ZY-zhangye/riscv-cpu-refactored/doc/HANDOFF_20261018.md

# 2026-10-18 HelloZynq 五级 RV32 SoC 工作区交接

交接时区：Asia/Singapore（UTC+08:00）。工作区 `W:\riscv-cpu-refactored`，分支 `dev/linux-bringup`。本轮目标是把**现有单发顺序五级 RV32 SoC**适配到 HelloZynq-7020，以片内 ROM/BRAM、UART 和裸机 CoreMark 验证并扫描频率。本轮没有实现 Linux、Sv32、cache、A 扩展或新增 CPU 功能；分支名字和既有 Linux 路线不改变这个范围。

## 接手首先掌握

- 50 MHz smoke 已在真实板卡输出 `SMOKE_PASS`，50 MHz CoreMark 有效通过。
- 本轮 10 MHz 步进里，**100 MHz 是同时满足所设 STA 约束并通过 CoreMark 的最高点**；WNS `+0.259 ns`、WHS `+0.048 ns`，CoreMark `214.830878`。
- **160 MHz 是实板 CoreMark 最高通过点**，两次运行复现，`343.752372` CoreMark、`2.148452` CoreMark/MHz，CRC 正确，计时 `17.454425 s`、6,000 次迭代。它的 WNS 为 **−2.449 ns**，属于超频实验，不是时序保证频率。
- 170 MHz 两次下载后分别采集约 180 秒，均 0 字节、没有 BOOT/结果；没有得到 CRC 错误。未测 165 MHz，不能宣称精确频率极限。
- 最后恢复并验证的是 **160 MHz 易失 JTAG 配置**，最后成功下载记录为当日 `21:25:35 +08:00`。没有写 QSPI/SD；断电后须重新加载。计算机关机若使板卡失电也会丢失配置。
- `rtl/cpu_top/` 本轮未改；不要将板级接线、SoC 返回时序修复和除法器替换描述为新增流水线架构。

详细性能、STA、资源和限制以 [HELLOZYNQ_COREMARK_RESULTS.md](HELLOZYNQ_COREMARK_RESULTS.md) 为准；准备阶段资料见 [HELLOZYNQ_BOARD_READINESS.md](HELLOZYNQ_BOARD_READINESS.md)，其中“尚未实板运行”等文字是该阶段历史状态。

## 本轮文件与行为变化

| 文件/目录 | 内容 |
| --- | --- |
| `rtl/my_cpu/my_cpu.sv` | 增加 `BOARD_MEMORY`、`INST_INIT_FILE`、`DATA_INIT_FILE`；真实同步 ROM/BRAM 初始化与仿真旧路径共存 |
| `rtl/my_cpu/bridge.sv` | 修正 UART/Timer/PLIC 同边沿更新 rdata 后被再次采到旧值的问题；按同步 BRAM/旧组合读 RAM 分别适配返回 |
| `rtl/board/hellozynq_top.sv` | HelloZynq 引脚壳、MMCM、BUFG、等待 LOCKED 后同步释放复位及上电延迟；直接实例现有 SoC |
| `rtl/board/rv32_divider_hw.sv` | 可综合的真实 32 步迭代除法器，模块名 `divider`；板级清单用它替换 `rtl/cpu_top/divider.sv`，不能同时编入 |
| `board/hellozynq/hellozynq.xdc` | 6 个板级 IO、50 MHz 输入时钟及外部异步边界约束 |
| `board_tests/platform/board_start.S`、`board_linker.ld`、`board_runtime.c/.h` | 裸机启动、BSS/栈、极小整数打印、Timer 和 UART 移植 |
| `board_tests/00_smoke/main.c` | 最小功能启动/外设验证程序 |
| `board_tests/05_coremark/src/core_portme.c/.h` | 当前平台移植和精确计分；CoreMark 五份算法/框架源保持原内容 |
| `scripts/` | 固件构建和 ELF/镜像检查、独立 Vivado 工程、串口采集、ISA 回归、频率扫描 |
| `test/tb_soc_bus_response.sv`、`tb_board_divider.sv`、`tb_board_firmware.sv` | SoC 总线集成、真实除法器和整核裸机固件验证 |
| `doc/board_evidence/2026-10-18/` | 可进入版本管理的报告、参数、哈希与最终 UART 原始字节 |

原始 CPU 五级流水、UART/Timer/PLIC 主体及日常 `run_all.bat` 保持原范围。当前 FPU 仍是占位实现，`INSTRET` 仍有估算补偿，本轮结果不能换算 IPC、CPI 或 MIPS。

## 工具与硬件

| 工具/资料 | 当前绝对路径 |
| --- | --- |
| Vivado 2023.2 | `W:\APP\Xilinx\Vivado\2023.2\bin\vivado.bat` |
| Questa 2024.1 | `W:\questasim64_2024.1\win64\`，含 `vlib.exe/vmap.exe/vlog.exe/vsim.exe` |
| Windows 原生 RISC-V GCC 15.2.0-1 | `F:\Tools\Apps\xpack-riscv-none-elf-gcc-15.2.0-1\bin\` |
| Python 3.14 | 本机 Python 3.14，`python` 在 PATH 中 |
| 串口 Python（已装 pyserial） | 已装 pyserial 的独立 venv，下文记为 `<serial-python>` |
| PowerShell 7 | `pwsh` 在 PATH 中 |
| Icarus | `C:\ProgramData\chocolatey\bin\iverilog.exe`，同目录 `vvp.exe` |
| 原厂资料 | `F:\BaiduNetdiskDownload\zynq` |

Vivado 工程采用教程候选 part `xc7z020clg484-2`，实物 JTAG 只确认 `xc7z020`，封装 CLG484 来自用户提供的文字。**实物速度档、温度等级、PCB 版本未核实**，不要用工程 part 反推实物 -2/I。V1.0 按键及排针丝印有厂商勘误，以球位而不是 KEY1/2 名称为准。

| 顶层信号 | CLG484 球位 | 约定 |
| --- | --- | --- |
| `clk` | M19 | 板载 50 MHz，20 ns，LVCMOS33 |
| `rst_n` | J20 | 上拉、按下接地；低有效 PL 用户按键 |
| `uart_rx` | M17 | CH340E TX → FPGA，LVCMOS33 |
| `uart_tx` | L17 | FPGA → CH340E RX，LVCMOS33 |
| `led[0:1]` | P20/P21 | 高有效，LVCMOS33 |

UART 在 PL Bank34，原理图 `PS_UART_*` 只是网名；无需 PS MIO/EMIO。主机此前为 COM6，CH340 VID/PID `1A86:7523`，115200/8N1/无流控，重插后重新枚举。唯一 JTAG 目标曾为 `localhost:3121/xilinx_tcf/Digilent/<序列号>`；每次 Program 都重新检查。正确 DONE 属性为 `REGISTER.CONFIG_STATUS.BIT13_DONE_INTERNAL_SIGNAL_STATUS` 和 `REGISTER.CONFIG_STATUS.BIT14_DONE_PIN`，旧缩写 `BIT13_DONE` 不存在。

SoC 普通 reset PC=`0x80000000`，指令 ROM 16 KiB；数据 RAM=`0x80100000..0x8013FFFF`，256 KiB，栈顶=`0x80140000`。UART/Timer/LED 基址依次为 `0x80010000/0x80020000/0x80030000`，PLIC 在 `0x8030xxxx`。编译为 `rv32im_zicsr/ilp32`，不能用 xPack 默认 `rv32imac` 引入未实现 A/C。UART 使用内部 CPU 时钟分频，CTRL=`0x14`；50 MHz BAUD=`433`，160 MHz BAUD=`1388`。

## 构建、恢复、下载和采集

以下从 `W:\riscv-cpu-refactored` 的 PowerShell 7 运行。每次选择全新输出目录；示例中的 `new_*` 是待生成目录，不代表已有证据。`Gen` 只生成固件和配置，`Build` 生成独立 Vivado 工程/报告/bit。本机旧 npm PATH 联接曾使 Vivado 崩溃，入口已仅对子进程采用最小 PATH；不需修改全局 PATH。

```powershell
# 新建50 MHz smoke：编译、检查镜像、综合、实现与写bit
pwsh -File scripts/run_board.ps1 -Mode Build -App smoke -CpuHz 50000000 -Iterations 0 -BuildDir W:\riscv-cpu-refactored\build\hello_zynq\new_smoke50

# 新建100 MHz正式CoreMark，iterations=0由固件校准到至少10秒
pwsh -File scripts/run_board.ps1 -Mode Build -App coremark -CpuHz 100000000 -Iterations 0 -BuildDir W:\riscv-cpu-refactored\build\hello_zynq\new_core100

# 仅构建固件：inst.mem/data.mem、ELF、dump、COE和manifest
python scripts/build_board_firmware.py --app coremark --cpu-hz 100000000 --iterations 0 --output W:\riscv-cpu-refactored\build\hello_zynq\new_firmware100

# 已完成route但只在报告/写bit阶段失败时复用，不重跑综合/实现
pwsh -File scripts/run_board.ps1 -Mode Finish -BuildDir <已有构建目录>

# 在一个终端先开被动采集；output必须是新目录，等待CAPTURE_READY
& <serial-python> scripts/board_capture.py --port COM6 --baud 115200 --duration 180 --cpu-hz 100000000 --require-valid-coremark --output W:\riscv-cpu-refactored\build\hello_zynq\new_capture100

# 另一个终端再加载已检查的bit（会改变板上易失配置）
pwsh -File scripts/run_board.ps1 -Mode Program -BuildDir <已有100MHz构建目录>
```

`Program` 依据 `build_summary.json` 校验 bit SHA-256、DRC 和唯一目标，然后检查 DONE、要求 `BOARD_PROGRAM_SUCCESS`。160 MHz 等 STA 未收敛点必须显式加 `-AllowTimingFailure`，不能把它写成基线 PASS。`Finish` 只容许两份报告脚本变化；RTL/XDC/镜像变化需新建完整构建，不要删除快照或绕过检查。采集器只收字节不发串口命令；遇 CoreMark 结果会独立复算，不够 10 秒为 SHORT。不要将 smoke程序不存在的 PING/ECHO 协议套过来。

频率扫描入口 `scripts/run_frequency_campaign.py` 默认每点独立构建、先采集后下载，`--confirm-failure` 对首次失败再试一次。仅查看计划、不触硬件可用：

```powershell
python scripts/run_frequency_campaign.py --start-mhz 60 --step-mhz 10 --max-mhz 170 --iterations 0 --root-output W:\riscv-cpu-refactored\build\hello_zynq\new_campaign --plan-only
```

当前已测固件 builder 限制最高 **200 MHz**，而 campaign 参数默认最高为 400 MHz。重新运行时应显式设置 `--max-mhz` 不超过 200；超出会被 builder 拦截，属于 `TOOL_BLOCKED`，不是实板频率失败。为保持已测源码哈希，收尾未改这两处限制。

## 回归与已完成验证

本轮隔离 Questa 回归为 **77/77 指令用例、8/8 定向测试 PASS**，共享 `hex/riscv-tests/rv32-p-riscv.hex` 前后 SHA 一致。真实除法器裸接口 1,098 组、mul 集成 540 组及 kill/drain/reset 通过；SoC sync/async 返回共17项检查通过；50 MHz smoke及短 CoreMark整核仿真通过。原始回归与板级构建的 divider选择不同，不能只通过旧行为模型就替代硬件除法器验收。

```powershell
python scripts/run_board_regression.py --build-dir W:\riscv-cpu-refactored\build\hello_zynq\new_regression --tool-dir W:\questasim64_2024.1\win64
pwsh -File run_board_divider.ps1 -BuildDir W:\riscv-cpu-refactored\build\hello_zynq\new_divider
pwsh -File scripts/run_board_firmware_sim.ps1 -FirmwareDir <已构建smoke固件目录> -PassText SMOKE_PASS -BuildDir W:\riscv-cpu-refactored\build\hello_zynq\new_firmware_sim
```

旧 `run_all.bat all` 也保留，但会临时覆盖共享 HEX且末尾pause；优先用上述隔离入口。新建回归目录避免混用旧 work 库。

收尾时为补齐持久日志，已重跑硬件除法定向测试，结果 `BOARD_DIVIDER_PASS raw=1098 mul=540 kill_drain=3 reset=2`，见 `build/hello_zynq/handoff_checks/board_divider.log`。

## STA、CDC及结果边界

50 MHz CoreMark WNS=`+5.950 ns`、WHS=`+0.060 ns`，成绩 `107.415435`。160 MHz WNS=`−2.449 ns`、TNS=`−6463.526 ns`、WHS=`+0.062 ns`、THS=0；失败端点包括5,511个CPU setup和671个reset recovery，最差 EX 结果路径 `ds_to_es_bus_r_reg[5]` → `skid_exe_result_reg[25]`，以及板级复位扇出。170 MHz WNS=`−2.984 ns`、WHS=`+0.050 ns`；不能说hold失败。

160 MHz全SoC资源：LUT 6,723、FF 5,368、BRAM36 68/140、DSP 4/220。DRC严重项为0仍有33条Warning；CDC为 **CDC-7 Critical 12条、CDC-2 Warning 1条、CDC-9 Info 1条**，涉及复位异步端和UART同步链属性。没有通过全CDC签收；不要用“DRC严重项0”写成所有检查全绿。默认活动功耗估计不是实测功耗。

## 保留的证据与交付物

| 内容 | 路径（相对仓库） |
| --- | --- |
| 参数、性能与限制主报告 | `doc/HELLOZYNQ_COREMARK_RESULTS.md` |
| 可持久保留的160MHz原始报告/参数/串口 | `doc/board_evidence/2026-10-18/160mhz/` |
| 全频率结果 | `doc/board_evidence/2026-10-18/frequency_results.csv`、`frequency_results.json` |
| 本轮完整扫描记录 | `build/hello_zynq/campaign_10mhz_20261018/campaign.json` |
| 已通过50MHz构建 | `build/hello_zynq/coremark_50_base/`，smoke为 `build/hello_zynq/smoke_50_v2/` |
| 最后160MHz bit/固件/配置/下载记录 | `build/hello_zynq/campaign_10mhz_20261018/coremark_160MHz/` |
| 100MHz时序满足镜像 | `build/hello_zynq/campaign_10mhz_20261018/coremark_100MHz/hellozynq.bit` |
| 最后160MHz原始串口 | `build/hello_zynq/campaign_10mhz_20261018/final_160MHz_capture/` |
| 隔离回归汇总 | `build/hello_zynq/isa_regression/regression_results.json` |
| 参数说明附件包 | `build/hello_zynq/reports/HelloZynq-160MHz-parameters-20261018.zip` |

`build/` 属于忽略的本地产物。主工作区保留所有实板构建项目以及100/160MHz镜像，只在归档后清理可再生Questa库/空 `.Xil` 等缓存；文档证据目录已经复制并逐文件核对160MHz关键材料。收尾归档目录指定为 `F:\Tools\Archives\riscv-cpu-refactored\2026-10-18\`，归档完成与否及每个文件的实际SHA以该目录最终的 `handoff-manifest.json` 为准。规划包含 `source-and-history.bundle`、`source-snapshot.zip`、`board-builds-and-evidence.zip`；这些名字是收尾输出约定，不冒充文档编写时已经验证的文件。源代码将做本地git提交、不推送；接手执行 `git log -1 --oneline` 查看实际最新提交。不要把只有文本报告的参数包误认为完整可重载镜像包。

最终160MHz bit SHA-256=`e54c1900dfd46192d3420c7d33409db9ff96f67ad293f3adb3fe076308596109`；ELF=`d7d04054163038a7f805ef723ee49050ddd4f9ba50cc743f4276f230fd379d5c`；最终UART原始字节=`847be1f58ae811f11d26c883e12da18470a6a15f193e3e96661674f4388aae8a`。先核对哈希再重载，不从缓存项目重新生成后仍声称是同一实测镜像。

两点历史复现边界：`smoke_50_v2` 使用 CRLF 修复前的 runtime，应保留原 ELF/mem 与 manifest，不可用当前源码重建后仍标为原镜像。`board_capture.py` 保存的 `uart.txt` 可有 Windows 文本换行导致的 CRCRLF 空行，以 `rx.bin/rx.jsonl` 作为原始字节证据；文档证据目录另有 `uart_normalized.txt`。工程/manifest 包含本机绝对 W/F/C 路径，换机应使用新输出目录及工具参数重建，不假定压缩包移位后 XPR 可直接原样打开。

## 后续权限

接手后先查看本地git提交、交接包清单与文档证据，确认硬件是否仍供电、COM/JTAG是否变化。后续是否修复高频路径、优化reset/CDC、细测165MHz或进入Linux路线，均由用户决定；不要因为尚有性能/规范缺口就自行扩展CPU功能或继续频率扫描。
