ZY-zhangye/riscv-cpu-refactored/doc/board_evidence/2026-10-18/frequency_results.csv

MHz | attempt | runtime_status | iterations | cycles | duration_seconds | score | per_MHz | WNS_ns | WHS_ns | timing_met | UART_bytes
50 | 1 | PASS | 2000 | 930964900 | 18.619298 | 107.4154353187751761639993087 | 2.148308706375503523279986174 | 5.95 | 0.06 | True | 1275
60 | 1 | PASS | 2000 | 930964860 | 15.516081 | 128.8985279208068068219030308 | 2.14830879868011344703171718 | 3.07 | 0.088 | True | 1468
70 | 1 | PASS | 2000 | 930964860 | 13.299498 | 150.3816159076079412922202026 | 2.14830879868011344703171718 | 0.943 | 0.06 | True | 1468
80 | 1 | PASS | 3000 | 1396582880 | 17.457286 | 171.8480180710793189731783050 | 2.148100225888491487164728812 | 0.93 | 0.059 | True | 1471
90 | 1 | PASS | 3000 | 1396447200 | 15.51608 | 193.3478043423338884563626895 | 2.14830893713704320507069655 | 0.242 | 0.06 | True | 1471
100 | 1 | PASS | 3000 | 1396447300 | 13.964473 | 214.8308783296011242243083574 | 2.148308783296011242243083574 | 0.259 | 0.048 | True | 1476
110 | 1 | PASS | 3000 | 1396447250 | 12.694975 | 236.3139746238176916457102121 | 2.148308860216524469506456474 | -0.267 | 0.071 | False | 1476
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
