ZY-zhangye/riscv-cpu-refactored/rtl/cpu_top/cpu_top.sv

`include "defines.svh"
module cpu_top (
    input logic clk,
    input logic rst_n,
    //指令存储器接口
    input logic [31:0] imem_rdata,
    output logic [31:0] imem_addr,
    output logic imem_en,
    //数据存储器接口
    input logic [31:0] dmem_rdata,
    output logic [31:0] dmem_addr,
    output logic [3:0] dmem_wen,
    output logic dmem_en,
    output logic [31:0] dmem_wdata,
    //plic接口
    input logic plic_irq
    //debug接口
    `ifdef DEBUG_EN
    ,
    output logic [31:0] debug_wb_pc,
    output logic [4:0] debug_wb_rf_addr,
    output logic [31:0] debug_wb_rf_data,
    output logic debug_wb_rf_wen,
    output logic debug_wb_fpu_rf_wen,
    output logic [31:0] debug_data
    `endif
);

    //连接if模块
    logic ds_allowin;
    logic fs_to_ds_valid;
    logic [`FS_DS_WIDTH-1:0] fs_to_ds_bus;
    logic br_taken;
    logic [31:0] br_target;
    logic br_redirect;
    logic [31:0] br_redirect_target;
    logic bp_update_valid;
    logic [31:0] bp_update_pc;
    logic bp_update_taken;
    logic [31:0] bp_update_target;
    logic bp_update_is_jalr;
    logic [`EXC_WIDTH-1:0] fs_exc_bus;
    logic exception_flag;
    logic [31:0] exception_addr;
    logic external_irq_enable;

    //连接id模块
    logic [4:0] rs1_addr;
    logic [4:0] rs2_addr;
    logic [31:0] rs1_data;
    logic [31:0] rs2_data;
    logic [4:0] rs1_fpu_addr;
    logic [4:0] rs2_fpu_addr;
    logic [4:0] rs3_fpu_addr;
    logic rs3_fpu_ren;
    logic [31:0] rs1_fpu_data;
    logic [31:0] rs2_fpu_data;
    logic [11:0] csr_addr;
    logic [31:0] csr_data;
    logic ds_to_es_valid;
    logic es_allowin;
    logic ds_flush;
    logic [`DS_ES_WIDTH-1:0] ds_to_es_bus;
    logic regfile_wen;
    logic reg_fpu_wen;
    logic [4:0] regfile_waddr;
    logic [`DATA_WIDTH-1:0] regfile_wdata;
    logic [4:0] exe_dest_addr;
    logic exe_regfile_wen;
    logic exe_reg_fpu_wen;
    logic [11:0] exe_csr_addr;
    logic exe_csr_wen;
    logic exe_load_pending;
    logic exe_lw_live_ok;
    logic exe_stack_lw_hit;
    logic exe_store_pending;
    logic exe_result_pending;
    logic stack_query_valid;
    logic [31:0] stack_query_addr;
    logic stack_query_hit;
    logic [31:0] stack_query_data;
    logic stack_capture_valid;
    logic [31:0] stack_forward_data;
    logic stack_store_valid;
    logic stack_store_allocate;
    logic [4:0] mem_dest_addr;
    logic mem_regfile_wen;
    logic mem_reg_fpu_wen;
    logic [`EXC_WIDTH-1:0] ds_exc_bus;

    //连接es模块
    logic es_valid;
    logic ms_allowin;
    logic es_to_ms_valid;
    logic [`ES_MS_WIDTH-1:0] es_to_ms_bus;
    logic es_flush;
    logic [31:0] mem_result;
    logic mem_lw_live_valid;
    logic [31:0] mem_lw_live_data;
    logic [31:0] reg_fpu_data3;
    logic [`EXE_EXC_BUS - 1:0] exe_exc_bus;

    //连接ms模块
    logic ms_valid;
    logic [`MS_WS_WIDTH-1:0] ms_to_ws_bus;
    logic ms_to_ws_valid;
    logic ws_allowin;
    logic csr_we;
    logic [11:0] csr_waddr;
    logic [31:0] csr_wdata;
    logic [6:0] exception_code;
    logic [31:0] exception_mtval;
    logic valid_inst;
    assign valid_inst = br_taken;

    //实例化
    if_stage u_if_stage (
        .clk(clk),
        .rst_n(rst_n),
        .pc_out(imem_addr),
        .inst_ren(imem_en),
        .inst_in(imem_rdata),
        .ds_allowin(ds_allowin),
        .fs_to_ds_valid(fs_to_ds_valid),
        .fs_to_ds_bus(fs_to_ds_bus),
        .br_taken(br_redirect),
        .br_target(br_redirect_target),
        .bp_update_valid(bp_update_valid),
        .bp_update_pc(bp_update_pc),
        .bp_update_taken(bp_update_taken),
        .bp_update_target(bp_update_target),
        .bp_update_is_jalr(bp_update_is_jalr),
        .fs_exc_bus(fs_exc_bus),
        .exception_flag(exception_flag),
        .exception_addr(exception_addr)
    );

    id_stage u_id_stage (
        .clk(clk),
        .rst_n(rst_n),
        .fs_to_ds_valid(fs_to_ds_valid),
        .fs_to_ds_bus(fs_to_ds_bus),
        .ds_allowin(ds_allowin),
        .rs1_addr(rs1_addr),
        .rs2_addr(rs2_addr),
        .rs1_data(rs1_data),
        .rs2_data(rs2_data),
        .rs1_fpu_addr(rs1_fpu_addr),
        .rs2_fpu_addr(rs2_fpu_addr),
        .rs3_fpu_addr(rs3_fpu_addr),
        .rs3_fpu_ren(rs3_fpu_ren),
        .rs1_fpu_data(rs1_fpu_data),
        .rs2_fpu_data(rs2_fpu_data),
        .csr_addr(csr_addr),
        .csr_data(csr_data),
        .ds_to_es_valid(ds_to_es_valid),
        .es_allowin(es_allowin),
        .ds_flush(ds_flush),
        .ds_to_es_bus(ds_to_es_bus),
        .regfile_wen(regfile_wen),
        .reg_fpu_wen(reg_fpu_wen),
        .regfile_waddr(regfile_waddr),
        .regfile_wdata(regfile_wdata),
        .exe_dest_addr(exe_dest_addr),
        .exe_regfile_wen(exe_regfile_wen),
        .exe_reg_fpu_wen(exe_reg_fpu_wen),
        .exe_csr_addr(exe_csr_addr),
        .exe_csr_wen(exe_csr_wen),
        .exe_load_pending(exe_load_pending),
        .exe_lw_live_ok(exe_lw_live_ok),
        .exe_stack_lw_hit(exe_stack_lw_hit),
        .exe_store_pending(exe_store_pending),
        .exe_result_pending(exe_result_pending),
        .es_valid(es_valid),
        .stack_query_valid(stack_query_valid),
        .stack_query_addr(stack_query_addr),
        .stack_query_hit(stack_query_hit),
        .mem_dest_addr(mem_dest_addr),
        .mem_regfile_wen(mem_regfile_wen),
        .mem_reg_fpu_wen(mem_reg_fpu_wen),
        .ms_valid(ms_valid),
        .br_taken(br_redirect),
        .exception_flag(exception_flag),
        .fs_exc_bus(fs_exc_bus),
        .ds_exc_bus(ds_exc_bus)
    );

    exe_stage u_exe_stage (
        .clk(clk),
        .rst_n(rst_n),
        .ds_to_es_valid(ds_to_es_valid),
        .ms_allowin(ms_allowin),
        .ds_to_es_bus(ds_to_es_bus),
        .ds_flush(ds_flush),
        .es_allowin(es_allowin),
        .es_to_ms_valid(es_to_ms_valid),
        .es_flush(es_flush),
        .es_to_ms_bus(es_to_ms_bus),
        .dmem_addr(dmem_addr),
        .dmem_wen(dmem_wen),
        .dmem_en(dmem_en),
        .dmem_wdata(dmem_wdata),
        .exe_dest_addr(exe_dest_addr),
        .exe_regfile_wen(exe_regfile_wen),
        .exe_reg_fpu_wen(exe_reg_fpu_wen),
        .exe_csr_addr(exe_csr_addr),
        .exe_csr_wen(exe_csr_wen),
        .exe_load_pending(exe_load_pending),
        .exe_lw_live_ok(exe_lw_live_ok),
        .exe_stack_lw_hit(exe_stack_lw_hit),
        .exe_store_pending(exe_store_pending),
        .exe_result_pending(exe_result_pending),
        .es_valid(es_valid),
        .ds_exc_bus(ds_exc_bus),
        .exception_flag(exception_flag),
        .br_taken(br_taken),
        .br_target(br_target),
        .br_redirect(br_redirect),
        .br_redirect_target(br_redirect_target),
        .bp_update_valid(bp_update_valid),
        .bp_update_pc(bp_update_pc),
        .bp_update_taken(bp_update_taken),
        .bp_update_target(bp_update_target),
        .bp_update_is_jalr(bp_update_is_jalr),
        .mem_result(mem_result),
        .mem_lw_live_valid(mem_lw_live_valid),
        .mem_lw_live_data(mem_lw_live_data),
        .stack_forward_data(stack_forward_data),
        .reg_fpu_data3(reg_fpu_data3),
        .stack_store_valid(stack_store_valid),
        .stack_store_allocate(stack_store_allocate),
        .exe_exc_bus(exe_exc_bus)
    );

    stack_value_buffer u_stack_value_buffer (
        .clk(clk),
        .rst_n(rst_n),
        .query_valid(stack_query_valid),
        .query_addr(stack_query_addr),
        .query_hit(stack_query_hit),
        .query_data(stack_query_data),
        .capture_en(exe_stack_lw_hit),
        .capture_addr(dmem_addr),
        .capture_flush(exception_flag || br_redirect),
        .captured_valid(stack_capture_valid),
        .captured_data(stack_forward_data),
        .store_valid(stack_store_valid),
        .store_allocate(stack_store_allocate),
        .store_addr(dmem_addr),
        .store_wstrb(dmem_wen),
        .store_wdata(dmem_wdata)
    );

    mem_stage u_mem_stage (
        .clk(clk),
        .rst_n(rst_n),
        .es_flush(es_flush),
        .es_to_ms_bus(es_to_ms_bus),
        .ms_to_ws_bus(ms_to_ws_bus),
        .es_to_ms_valid(es_to_ms_valid),
        .ms_to_ws_valid(ms_to_ws_valid),
        .ms_allowin(ms_allowin),
        .ws_allowin(ws_allowin),
        .dmem_rdata(dmem_rdata),
        .mem_dst_addr(mem_dest_addr),
        .mem_regfile_wen(mem_regfile_wen),
        .mem_reg_fpu_wen(mem_reg_fpu_wen),
        .mem_result(mem_result),
        .mem_lw_live_valid(mem_lw_live_valid),
        .mem_lw_live_data(mem_lw_live_data),
        .ms_valid(ms_valid),
        .exception_flag(exception_flag),
        .exe_exc_bus(exe_exc_bus),
        .plic_irq(plic_irq),
        .external_irq_enable(external_irq_enable),
        .csr_we(csr_we),
        .csr_waddr(csr_waddr),
        .csr_wdata(csr_wdata),
        .exception_code(exception_code),
        .exception_mtval(exception_mtval)
    );

    wb_stage u_wb_stage (
        .clk(clk),
        .rst_n(rst_n),
        .ms_to_ws_bus(ms_to_ws_bus),
        .ms_to_ws_valid(ms_to_ws_valid),
        .ws_allowin(ws_allowin),
        .regfile_wen(regfile_wen),
        .reg_fpu_wen(reg_fpu_wen),
        .regfile_addr(regfile_waddr),
        .regfile_wdata(regfile_wdata)
        `ifdef DEBUG_EN
        ,
        .debug_wb_pc(debug_wb_pc),
        .debug_wb_rf_addr(debug_wb_rf_addr),
        .debug_wb_rf_data(debug_wb_rf_data),
        .debug_wb_rf_wen(debug_wb_rf_wen),
        .debug_wb_fpu_rf_wen(debug_wb_fpu_rf_wen)
        `endif
    );

    regfiles u_regfiles (
        .clk(clk),
        .rst_n(rst_n),
        .regfile_wen(regfile_wen),
        .regfile_waddr(regfile_waddr),
        .regfile_wdata(regfile_wdata),
        .regfile_raddr1(rs1_addr),
        .regfile_rdata1(rs1_data),
        .regfile_raddr2(rs2_addr),
        .regfile_rdata2(rs2_data)
        `ifdef DEBUG_EN
        ,
        .debug_data(debug_data)
        `endif
    );

    reg_fpu u_reg_fpu (
        .clk(clk),
        .rst_n(rst_n),
        .reg_fpu_wen(reg_fpu_wen),
        .reg_fpu_waddr(regfile_waddr),
        .reg_fpu_wdata(regfile_wdata),
        .reg_fpu_raddr1(rs1_fpu_addr),
        .reg_fpu_rdata1(rs1_fpu_data),
        .reg_fpu_raddr2(rs2_fpu_addr),
        .reg_fpu_rdata2(rs2_fpu_data),
        .rs3_fpu_ren(rs3_fpu_ren),
        .reg_fpu_raddr3(rs3_fpu_addr),
        .reg_fpu_rdata3(reg_fpu_data3)
    );

    regfile_csr u_regfile_csr (
        .clk(clk),
        .rst_n(rst_n),
        .csr_wen(csr_we),
        .csr_waddr(csr_waddr),
        .csr_wdata(csr_wdata),
        .csr_raddr(csr_addr),
        .csr_rdata(csr_data),
        .exception_code(exception_code),
        .exception_mtval(exception_mtval),
        .br_taken(br_redirect),
        .ms_to_ws_valid(ms_to_ws_valid),
        .exception_flag(exception_flag),
        .exception_addr(exception_addr),
        .external_irq_enable(external_irq_enable)
    );



endmodule
