ZY-zhangye/riscv-cpu-refactored/rtl/my_cpu/PLIC.sv

`include "my_cpu_defines.svh"
module PLIC (
    input logic clk,
    input logic rst_n,
    // 外设中断输入
    input logic [`PLIC_NUM_INTERRUPTS-1:0] peripheral_interrupts,
    // CPU接口
    output logic plic_irq, // PLIC发出的中断请求信号
    // bridge路由的读写端口信号
    input logic plic_sel, // 选择信号，表示当前访问的是PLIC
    input logic plic_we,  // 写使能信号
    input logic plic_re,  // 读使能信号
    input logic [31:0] plic_addr, // 地址信号
    input logic [31:0] plic_wdata, // 写数据
    output logic [31:0] plic_rdata // 读数据
);


    // PLIC内部寄存器定义
    logic [`PRIORITY_WIDTH-1:0] priority_regs [`PLIC_NUM_INTERRUPTS-1:0]; // 优先级寄存器
    logic [`PLIC_NUM_INTERRUPTS-1:0] pending_regs; // 待处理寄存器
    logic [`PLIC_NUM_INTERRUPTS-1:0] enable_regs; // 使能寄存器
    logic [`PRIORITY_WIDTH-1:0] threshold_reg; // 阈值寄存器
    logic [`PLIC_NUM_INTERRUPTS-1:0] in_service_regs; // 处理中寄存器

    logic [`PLIC_NUM_INTERRUPTS-1:0] eligible_irqs;
    logic [7:0] prio_valid;
    logic [`ID_WIDTH-1:0] prio_id [0:7];
    logic [`ID_WIDTH-1:0] claim_id_next;
    logic claim_valid_next;
    logic [`ID_WIDTH-1:0] claim_id_r;
    logic claim_valid_r;

    assign eligible_irqs = pending_regs & enable_regs & ~in_service_regs;

    // Split the 32-way priority search into 8 priority buckets, then choose the
    // highest bucket above threshold. plic_irq/claim are registered below to
    // keep this selector out of the CPU interrupt timing path.
    always_comb begin
        integer i;
        integer p;

        prio_valid = '0;
        claim_id_next = '0;
        claim_valid_next = 1'b0;

        for (p = 0; p < 8; p++) begin
            prio_id[p] = '0;
        end

        for (i = `PLIC_NUM_INTERRUPTS - 1; i > 0; i--) begin
            if (eligible_irqs[i]) begin
                prio_valid[priority_regs[i]] = 1'b1;
                prio_id[priority_regs[i]] = i[`ID_WIDTH-1:0];
            end
        end

        for (p = 7; p > 0; p--) begin
            if (!claim_valid_next && prio_valid[p] && (p > threshold_reg)) begin
                claim_id_next = prio_id[p];
                claim_valid_next = 1'b1;
            end
        end
    end

    // PLIC寄存器读写逻辑
    function automatic logic [31:0] read_reg(input logic [31:0] addr);
        automatic int unsigned idx;
        begin
            if ((addr >= `PLIC_PRIORITY_BASE_ADDR) &&
                (addr < (`PLIC_PRIORITY_BASE_ADDR + (`PLIC_NUM_INTERRUPTS * 4)))) begin
                idx = (addr - `PLIC_PRIORITY_BASE_ADDR) >> 2;
                read_reg = {{(32-`PRIORITY_WIDTH){1'b0}}, priority_regs[idx]};
            end else begin
                case (addr)
                    `PLIC_PENDING_BASE_ADDR:     read_reg = pending_regs;
                    `PLIC_ENABLE_BASE_ADDR:      read_reg = enable_regs;
                    `PLIC_THRESHOLD_BASE_ADDR:   read_reg = {{(32-`PRIORITY_WIDTH){1'b0}}, threshold_reg};
                    `PLIC_IN_SERVICE_BASE_ADDR:  read_reg = in_service_regs;
                    default:                     read_reg = 32'hDEAD_BEEF; // 无效地址返回特定值
                endcase
            end
        end
    endfunction

    task automatic write_reg(input logic [31:0] addr, input logic [31:0] data);
        automatic int unsigned idx;
        begin
            if ((addr >= `PLIC_PRIORITY_BASE_ADDR) &&
                (addr < (`PLIC_PRIORITY_BASE_ADDR + (`PLIC_NUM_INTERRUPTS * 4)))) begin
                idx = (addr - `PLIC_PRIORITY_BASE_ADDR) >> 2;
                if (idx != 0) begin
                    priority_regs[idx] <= data[`PRIORITY_WIDTH-1:0];
                end
            end else begin
                case (addr)
                    `PLIC_ENABLE_BASE_ADDR:     enable_regs <= {data[`PLIC_NUM_INTERRUPTS-1:1], 1'b0};
                    `PLIC_THRESHOLD_BASE_ADDR:  threshold_reg <= data[`PRIORITY_WIDTH-1:0];
                    default:                    ;
                endcase
            end
        end
    endtask

    always_ff @(posedge clk) begin
        integer i;
        logic [`PLIC_NUM_INTERRUPTS-1:0] pending_next;
        logic [`PLIC_NUM_INTERRUPTS-1:0] in_service_next;
        logic [`PLIC_NUM_INTERRUPTS-1:0] claim_mask;
        logic [`PLIC_NUM_INTERRUPTS-1:0] release_mask;

        if (!rst_n) begin
            for (i = 0; i < `PLIC_NUM_INTERRUPTS; i++) begin
                priority_regs[i] <= '0;
            end
            pending_regs <= '0;
            enable_regs <= '0;
            threshold_reg <= '0;
            in_service_regs <= 32'd0;
            claim_id_r <= '0;
            claim_valid_r <= 1'b0;
            plic_irq <= 1'b0;
            plic_rdata <= 32'd0;
        end else begin
            pending_next = pending_regs | (peripheral_interrupts & ~in_service_regs);
            in_service_next = in_service_regs;
            claim_mask = '0;
            release_mask = '0;

            if (plic_sel && plic_re) begin
                if (plic_addr == `PLIC_CLAIM_BASE_ADDR) begin
                    if (claim_valid_r) begin
                        plic_rdata <= claim_id_r;
                        claim_mask[claim_id_r] = 1'b1;
                    end else begin
                        plic_rdata <= 32'd0;
                    end
                end else begin
                    plic_rdata <= read_reg(plic_addr);
                end
            end

            if (plic_sel && plic_we) begin
                if (plic_addr == `PLIC_CLAIM_BASE_ADDR) begin
                    if ((plic_wdata[`ID_WIDTH-1:0] != '0) &&
                        (plic_wdata[`ID_WIDTH-1:0] < `PLIC_NUM_INTERRUPTS) &&
                        in_service_regs[plic_wdata[`ID_WIDTH-1:0]]) begin
                        release_mask[plic_wdata[`ID_WIDTH-1:0]] = 1'b1;
                    end
                end else begin
                    write_reg(plic_addr, plic_wdata);
                end
            end

            pending_next = pending_next & ~claim_mask;
            pending_next[0] = 1'b0;
            in_service_next = (in_service_next | claim_mask) & ~release_mask;
            in_service_next[0] = 1'b0;

            pending_regs <= pending_next;
            in_service_regs <= in_service_next;
            claim_id_r <= claim_id_next;
            claim_valid_r <= claim_valid_next;
            plic_irq <= claim_valid_next;
        end
    end




endmodule
