ZY-zhangye/riscv-cpu-refactored/sim/verilator/board_reference/top.sv

`timescale 1ns / 1ps
//////////////////////////////////////////////////////////////////////////////////
// Company:
// Engineer:
//
// Create Date: 04/16/2025 06:21:44 PM
// Design Name:
// Module Name: top
// Project Name:
// Target Devices:
// Tool Versions:
// Description:
//
// Dependencies:
//
// Revision:
// Revision 0.01 - File Created
// Additional Comments:
//
//////////////////////////////////////////////////////////////////////////////////


module top(
    input  wire i_sys_clk_p         ,
    input  wire i_sys_clk_n         ,
    input  wire i_uart_rx           ,
    output wire o_uart_tx           ,

    output wire [31:0] virtual_led  ,
    output wire [39:0] virtual_seg
`ifdef VERILATOR
    ,
    output wire [31:0] virtual_seg_value
`endif
);

    wire w_clk_50Mhz, cpu_clk;
    wire w_clk_rst;

    wire [7:0] virtual_key;
    wire [63:0] virtual_sw;

    wire [7:0] rx_data;
    wire rx_ready;
    wire tx_start;
    wire [7:0] tx_data;
    wire tx_busy;

    pll pll_inst(
        .clk_in1_p(i_sys_clk_p),
        .clk_in1_n(i_sys_clk_n),
        .clk_out1(w_clk_50Mhz),
        .clk_out2(cpu_clk),
        .locked(w_clk_rst)
    );

    uart #(
        .CLK_FREQ(50000000),
        .BAUD_RATE(9600)
    ) uart_inst(
        .clk(w_clk_50Mhz),
        .rst_n(w_clk_rst),
        .rx(i_uart_rx),
        .rx_data(rx_data),
        .rx_ready(rx_ready),
        .tx(o_uart_tx),
        .tx_data(tx_data),
        .tx_start(tx_start),
        .tx_busy(tx_busy)
    );

    twin_controller twin_controller_inst(
        .clk(w_clk_50Mhz),
        .rst_n(w_clk_rst),
        .rx_ready(rx_ready),
        .rx_data(rx_data),
        .tx_start(tx_start),
        .tx_data(tx_data),
        .tx_busy(tx_busy),
        .sw(virtual_sw),
        .key(virtual_key),
        .seg(virtual_seg),
        .led(virtual_led)
    );

    my_cpu my_cpu (
        .clk(cpu_clk),
        .clk_cnt(w_clk_50Mhz),
        .rst_n(w_clk_rst),
        .sw(virtual_sw),
        .key(virtual_key),
        .led(virtual_led),
        .seg(virtual_seg)
`ifdef VERILATOR
        ,
        .seg_value(virtual_seg_value)
`endif
    );

endmodule
