ZY-zhangye/riscv-cpu-refactored/sim/verilator/board_reference/perip_bridge.sv

`timescale 1ns / 1ps
//////////////////////////////////////////////////////////////////////////////////
// Company:
// Engineer:
//
// Create Date: 2025/04/22 10:25:24
// Design Name:
// Module Name: perip_bridge
// Project Name:
// Target Devices:
// Tool Versions:
// Description:
//
// Dependencies:
//
// Revision:
// Revision 0.01 - File Created
// Additional Comments:
//
//////////////////////////////////////////////////////////////////////////////////

module perip_bridge(
    input  logic         clk				,
    input  logic         cnt_clk			,
    input  logic         rst                ,

    input  logic [31:0]  perip_addr			,
    input  logic [31:0]  perip_wdata		,
    input  logic         perip_wen			,
    input  logic         perip_ren			,
	input  logic [3:0]	 perip_mask			,
    output logic [31:0]  perip_rdata		,

    input  logic [63:0]  virtual_sw_input	,
    input  logic [7:0]   virtual_key_input	,

	output logic [39:0]  virtual_seg_output	,
    output logic [31:0]  virtual_led_output,
    output logic [31:0]  virtual_seg_value
);
    localparam DRAM_ADDR_START = 32'h8010_0000;
    localparam DRAM_ADDR_END   = 32'h8013_FFFF;
    localparam SW0_ADDR  = 32'h8020_0000;  // sw[31:0]
    localparam SW1_ADDR  = 32'h8020_0004;  // sw[63:32]
    localparam KEY_ADDR  = 32'h8020_0010;  // key[7:0]
    localparam SEG_ADDR  = 32'h8020_0020;  // seg
    localparam LED_ADDR  = 32'h8020_0040;  // led[31:0]
    localparam CNT_ADDR  = 32'h8020_0050;  // counter
    localparam CNT_START_CMD = 32'h8000_0000;
    localparam CNT_STOP_CMD  = 32'hFFFF_FFFF;

    logic [31:0] LED;
    logic [31:0] seg_wdata, cnt_rdata, mmio_rdata, dram_rdata;
    logic [31:0] read_addr_d;
    logic [39:0] seg_output;
    logic cnt_enable_cfg, read_valid_d;
    logic dram_read_req, dram_region_sel, read_dram_region_sel;

    // 0x8010_0000~0x8013_FFFF 是一个天然的 256 KiB 对齐窗口。
    // 直接译码高 14 位，避免通用 32-bit 上下界比较器进入 BRAM WEA 路径。
    assign dram_region_sel =
        (perip_addr[31:18] == 14'b1000_0000_0001_00);
    assign read_dram_region_sel =
        (read_addr_d[31:18] == 14'b1000_0000_0001_00);

    // we don't care perip_mask in LED, SEG, SW & KEY, only care in DRAM
    // write process
    always_ff @(posedge clk) begin
        if (rst) begin
            LED            <= 32'd0;
            seg_wdata      <= 32'd0;
            cnt_enable_cfg <= 1'b0;
        end else if (perip_wen) begin
            case (perip_addr)
                LED_ADDR:   LED <= perip_wdata;
                SEG_ADDR:   seg_wdata <= perip_wdata;
                CNT_ADDR: begin
                    if (perip_wdata == CNT_START_CMD) begin
                        cnt_enable_cfg <= 1'b1;
                    end else if (perip_wdata == CNT_STOP_CMD) begin
                        cnt_enable_cfg <= 1'b0;
                    end
                end
            endcase
        end
    end

    // single-cycle-latency read timing:
    // cycle N   : perip_ren + perip_addr request
    // cycle N+1 : perip_rdata response
    always_ff @(posedge clk) begin
        if (rst) begin
            read_addr_d  <= 32'd0;
            read_valid_d <= 1'b0;
        end else begin
            read_addr_d  <= perip_addr;
            read_valid_d <= perip_ren;
        end
    end

    // mmio read data selected by delayed address
    always_ff @(posedge clk) begin
        case (perip_addr)
            SW0_ADDR:  mmio_rdata = virtual_sw_input[31:0];
            SW1_ADDR:  mmio_rdata = virtual_sw_input[63:32];
            KEY_ADDR:  mmio_rdata = {24'd0, virtual_key_input};
            SEG_ADDR:  mmio_rdata = seg_wdata;
            default:   mmio_rdata = 32'hDEAD_BEEF;
        endcase
    end

    // seg driver
    display_seg seg_driver (
        .clk    (cnt_clk),
        .rst    (rst),
        .s      (seg_wdata),
        .seg1   (seg_output[6:0]),
        .seg2   (seg_output[16:10]),
        .seg3   (seg_output[26:20]),
        .seg4   (seg_output[36:30]),
        .ans    ({seg_output[39:38], seg_output[29:28], seg_output[19:18], seg_output[9:8]})
    );

    assign seg_output[7]  = 0;
    assign seg_output[17] = 0;
    assign seg_output[27] = 0;
    assign seg_output[37] = 0;

    assign dram_read_req = perip_ren & dram_region_sel;

    // dram rw
    dram_driver dram_driver_inst (
        .clk				(clk),
        .perip_addr			(perip_addr[17:0]),
        .perip_wdata		(perip_wdata),
        .perip_mask			(perip_mask),
        .perip_ren 			(dram_read_req),
		.dram_wen 			(perip_wen & dram_region_sel),
        .perip_rdata		(dram_rdata)
    );

    // counter rw
    counter counter_inst (
        .cpu_clk            (clk),
        .cnt_clk            (cnt_clk),
        .rst                (rst),
        .cnt_enable_cpu     (cnt_enable_cfg),
        .perip_rdata		(cnt_rdata)
    );

    assign perip_rdata = read_valid_d ? (
                        ({32{read_addr_d == SW0_ADDR}} & mmio_rdata) |
                        ({32{read_addr_d == SW1_ADDR}} & mmio_rdata) |
                        ({32{read_addr_d == KEY_ADDR}} & mmio_rdata) |
                        ({32{read_addr_d == SEG_ADDR}} & mmio_rdata) |
                        ({32{read_dram_region_sel}} & dram_rdata) |
                        ({32{read_addr_d == CNT_ADDR}} & cnt_rdata)
                        ) : 32'd0;

    assign virtual_led_output = LED;
    assign virtual_seg_output = seg_output;
    assign virtual_seg_value = seg_wdata;

endmodule
