ZY-zhangye/riscv-cpu-refactored/(commit log)

2026-04-21 初始化仓库-完成基础指令集的设计
2026-04-21 增加一个python脚本程序以及封装方法
2026-04-28 删去脚本部分，只保留原生rtl代码以及相关部分
2026-04-28 改动-优化时序
2026-04-29 修正测试用hex文件用例；完成乘法模块框架，等待后续实例化IP核
    [index.csv]
2026-04-29 寄存一下，修复时序问题，目前乘法采用6级stall，主频185MHZ
2026-05-01 修正-优化时序
2026-05-01 修正：添加分支预测，已通过回归验证
2026-05-01 分支预测验证成功，CPI对比优化前大幅下降
2026-05-01 修正：load-use检测修正
2026-05-01 修正：修正指令提交计数逻辑
2026-05-07 修正：添加Z扩展相关资料并规范原有工程
2026-05-07 完成Z扩展初步实现，具体实现指令可见z_extensions_summary.md中A档
2026-05-11 修正：毕业设计前最后一版
2026-05-12 修正：SOC级封装添加PLIC，未验证
2026-05-13 修正：修正异常未flush取指阶段；修正mret指令未4字节对齐
2026-05-19 存档-初版架构确定
2026-05-31 feat: 添加PLIC/定时器模块及测试平台，配置.gitignore
    - 更新PLIC中断控制器和定时器模块
    - 新增UART、定时器测试平台(tb_UART.sv, tb_timer.sv)
    - 更新PLIC和CPU顶层测试平台
    - 添加.gitignore排除仿真中间文件(work/, transcript, results/)
    - 更新测试用指令hex文件
2026-06-03 添加项目README和FPGA测试资料
2026-06-16 Sync board-level RTL fixes
    [PLIC.sv, bridge.sv, exe_stage.sv, id_stage.sv, if_stage.sv, mem_stage.sv, regfile_csr.sv]
2026-06-17 fix pipeline flush and bridge read timing
    [bridge.sv, id_stage.sv]
2026-10-21 chore: carve RTL-only branch for Linux bring-up
    Keep only RTL, testbenches, riscv-tests images, the isolated Questa
    regression and Linux design docs. Board projects, constraints, bare-metal
    C, CoreMark, perf bench, Verilator board reference and board evidence stay
    on dev/linux-bringup.
    The synthesizable iterative divider moves to rtl/cpu_top/synth/ so the
    non-recursive rtl/cpu_top/*.sv globs keep compiling the behavioural
    divider; run_board_divider.ps1 follows the new path.
    Verified: isolated Questa regression isa=77/77 directed=8/8;
    BOARD_DIVIDER_PASS raw=1098 mul=540 kill_drain=3 reset=2.
2026-10-21 docs: add staged Questa RTL plan and riscv-tests baseline
    RTL_QUESTA_PLAN.md is the execution manual for the Questa-only phase:
    ground rules, test-asset handling, fixed technical decisions, stages
    S0-S7 with scope, boundaries, test lists and done criteria, directed
    test catalogue, and CSR / address-map appendices.
    The baseline CSV records every riscv-tests image run on commit 00c277f
    with tb_my_cpu. riscv-tests is built outside the workspace in
    W:\riscv-test; the plan references it instead of a submodule.
